eendeego/beacon/fritzing/Mega+Ethernet_v5.png

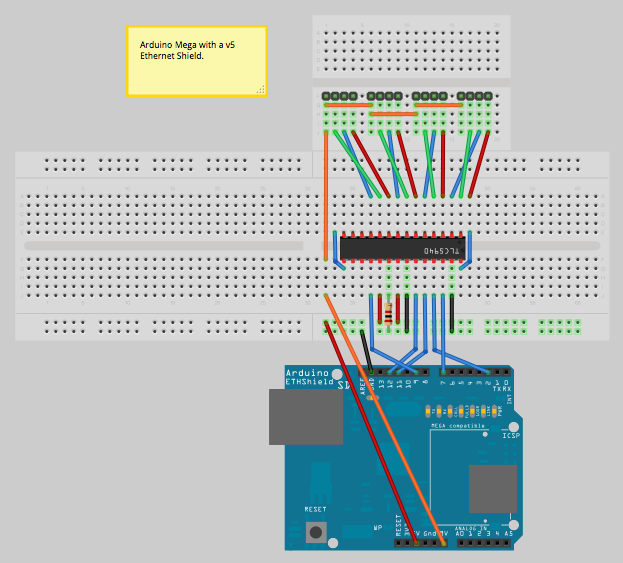
fritzing/Mega+Ethernet_v5.png
