eendeego/beacon/fritzing/Uno+Ethernet.png

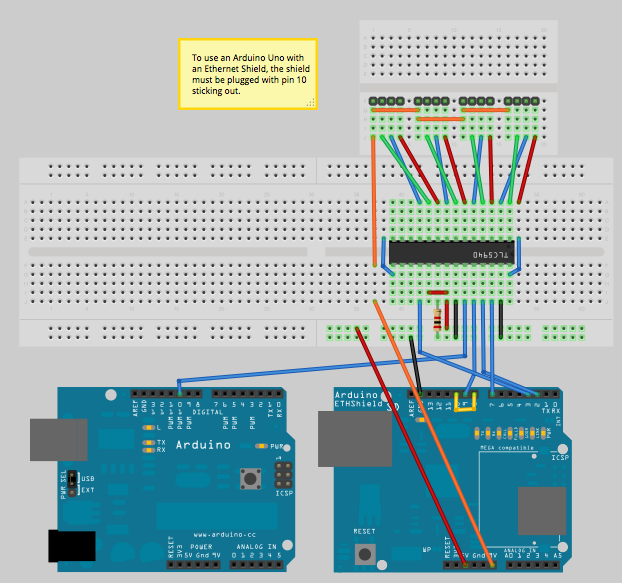
fritzing/Uno+Ethernet.png
