eendeego/beacon/(list of files, drawings)

Other design files:
fritzing/beacon_mega.fz
fritzing/beacon_uno.fz
